dtatum7/ESP32-RC/README.md

ESP32 based remote control system with 8 PWM outputs reconfigurable as controller ADC inputs with SparkFun QWIIC / Adafruit STEMMA connections for easy customization.
