dtatum7/ESP32-RC/ESP32-RC_R1.pdf

# WaCS-1 ESP32 Remote Robotics Control System

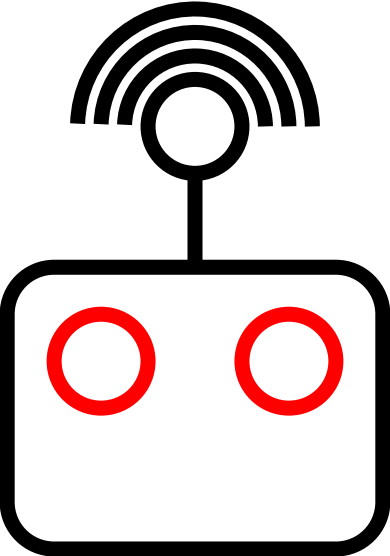
[picture p1: figure]

Dan Tatum
27 February 2025

## WaCS-1 ESP32 Remote Robotics Control System Overview

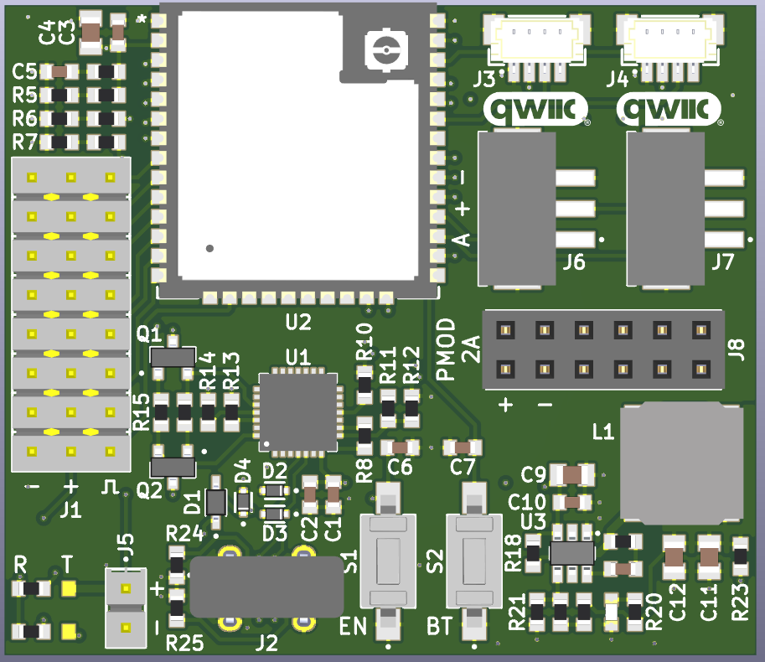
[picture p2: figure]

- Up to 8 PWM servos
- Dual SparkFun QWIIC / Adafruit STEMMA I²C connections
- Dual Adafruit STEMMA analog connections
- Digilent PMOD 2A SPI connection
- USB-C connector for firmware upload
- U.FL connector for improved antenna performance
- Voltage monitors for on board 3.3V supply, ESC, and external battery
- High efficiency switch mode power supply
- Reconfigurable to support potentiometer inputs from remote controller
- 1.92” x 1.66” PCBA area

## Up to 8 PWM Servos

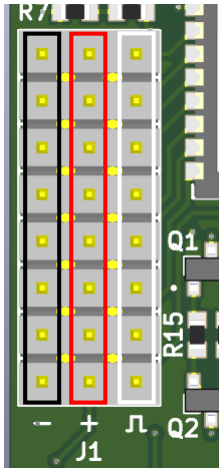
[picture p3: figure]
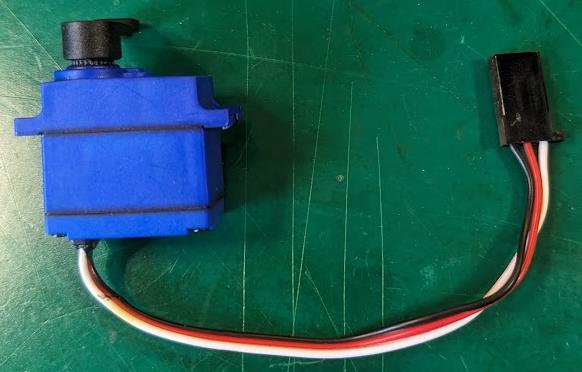
[picture p4: figure]

- Supports up to 8 PWM based servos
- 0.1” square pin headers
- ESC power pass through to servos
- Controller powered by ESC

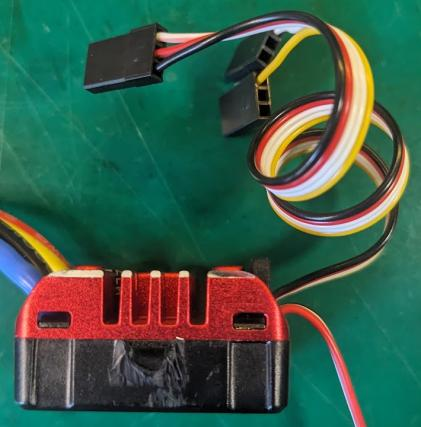
[picture p5: figure]

## Dual SparkFun QWIIC / Adafruit STEMMA QT

I

## 2C Connections

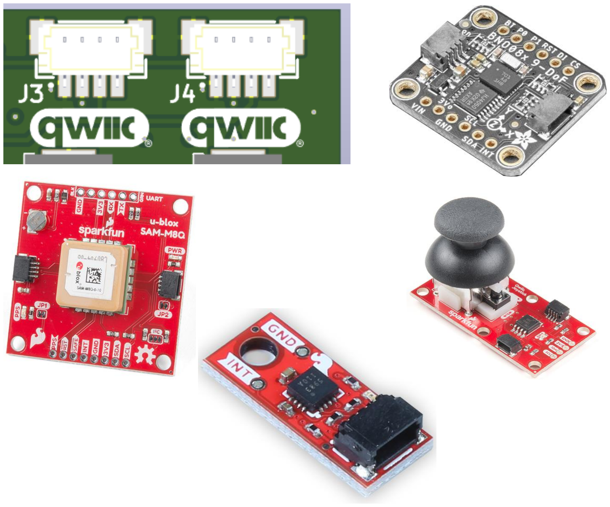
[picture p6: figure]

- A world of possibilities with readily
available off-the-shelf components
- JST type SH 4-pin 1mm connector
- GPS, IMU, screens, sensors, etc.
- Developers can focus on software and ditch the rat’s nest
- https://www.sparkfun.com/categories/399 (https://www.sparkfun.com/categories/399)
- https://www.adafruit.com/category/1018 (https://www.adafruit.com/category/1018)

## Dual Adafruit STEMMA Analog Connections

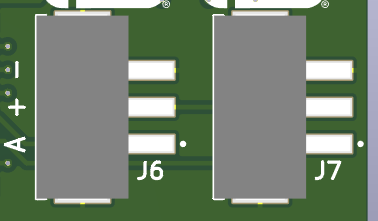
[picture p7: figure]
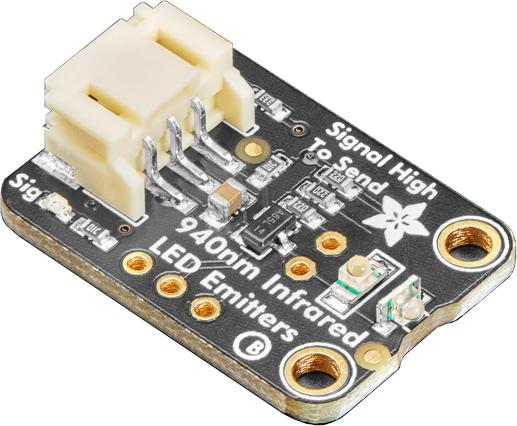
[picture p8: figure]

- Analog and GPIO
- A world of possibilities with
readily available off-the-shelf components
- JST type PH 3-pin 2mm
connector
- IR communication, buttons, amplifiers, etc.
- https://www.adafruit.com/category/1019 (https://www.adafruit.com/category/1019)

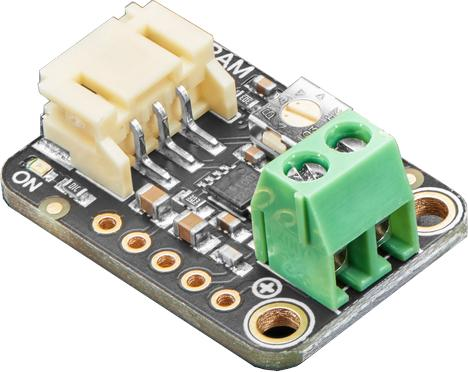
[picture p9: figure]
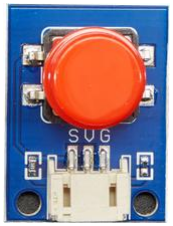
[picture p10: figure]

## Digilent PMOD 2A SPI Connection

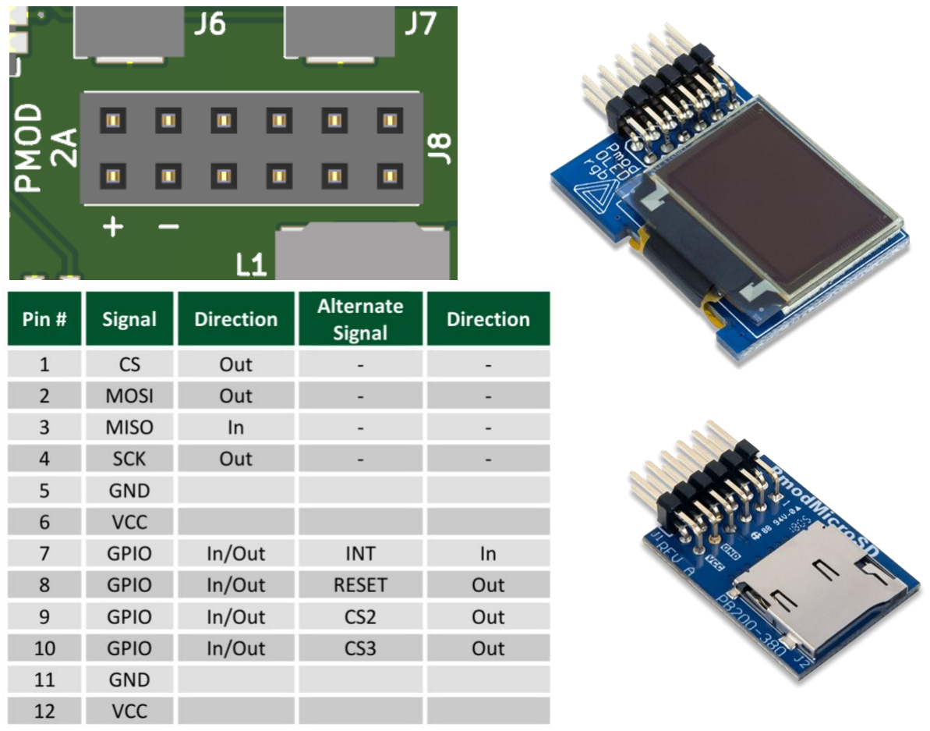
[picture p11: figure]

- Dual SPI connections
- A world of possibilities with
readily available off-the-shelf components
- 2x6 pin 0.1” square receptacle
- https://digilent.com/shop/products/fpga-boards/expansionmodules/pmods/ (https://digilent.com/shop/products/fpga-boards/expansion-modules/pmods/)

## USB-C connector for firmware upload

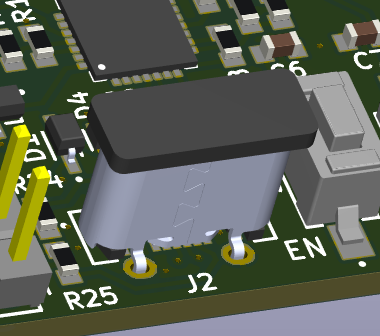
[picture p12: figure]
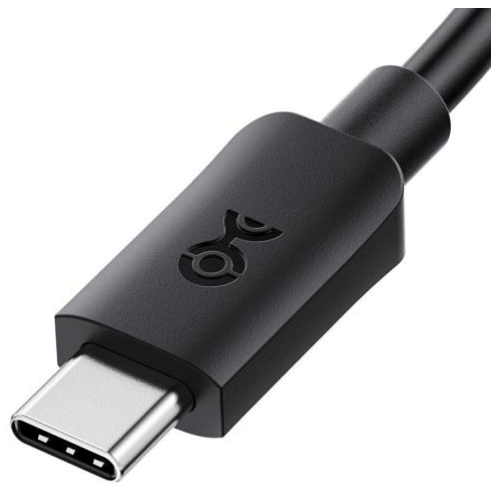
[picture p13: figure]

- Common, current, reversable
connection
- Integrated Silicon Labs CP2102 USB to serial converter
- No hunting for old, oddball cables or adapters
- Mounted perpendicular to board for easy in-unit access
- USB 2.0 for easy compatibility

## Additional Connections

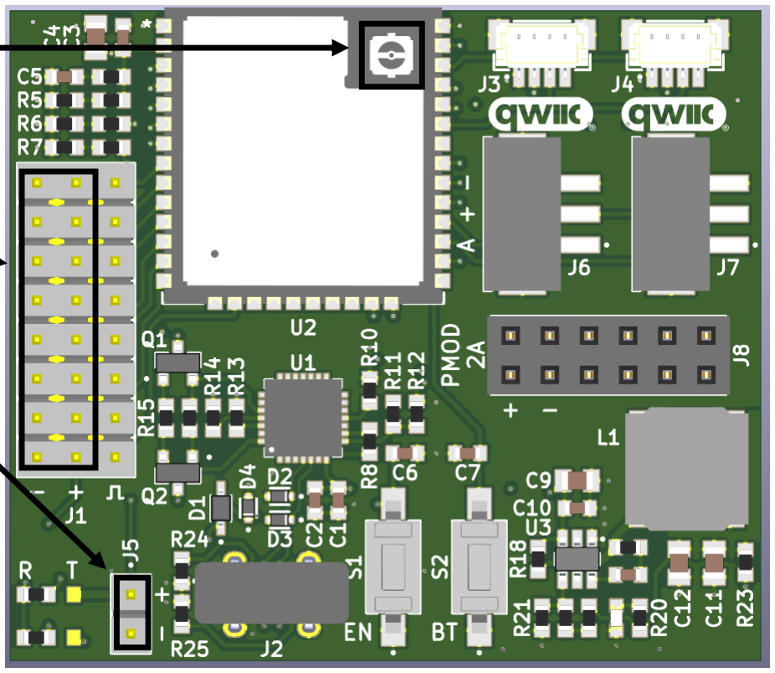
[picture p14: figure]

- U.FL connector for improved antenna performance
- Voltage monitors for on board 3.3V supply, ESC, and external battery

## High efficiency switch mode power supply

- Operational input voltage 4.2V-18V
- 3.3V, 2A output to PCBA and external accessories

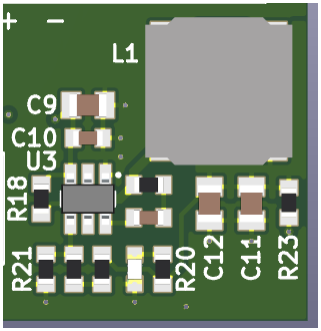
[picture p15: figure]

## Reconfigurable for Potentiometer Inputs from Remote Controller

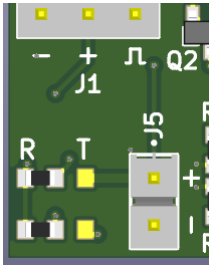
[picture p16: figure]

- Populate R1, R22 to left side
pads
- Input power sourced from J5 external power monitoring input
- J1 sources 3.3V to external potentiometers and connects wiper to ADC input
- Inputs reconfigured in software

# PCBA 3D View

## PCBA Front

## PCBA Back

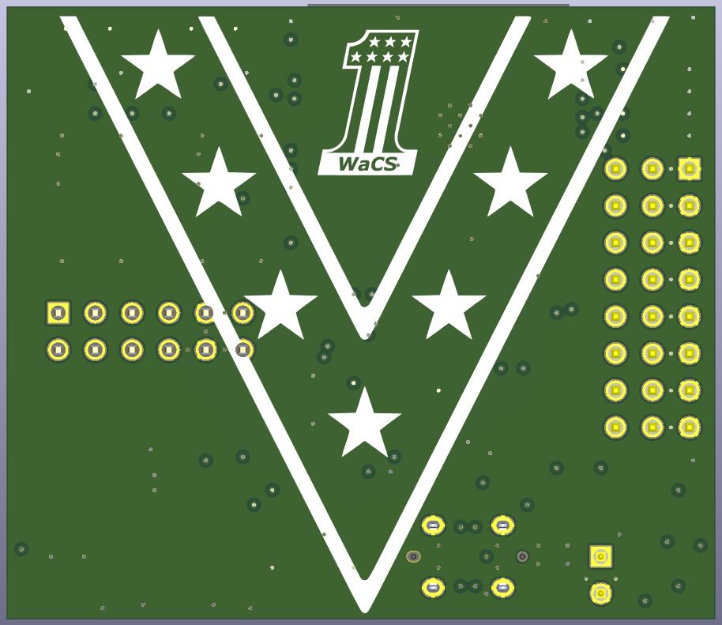
[picture p17: figure]

## PCBA Front Isometric

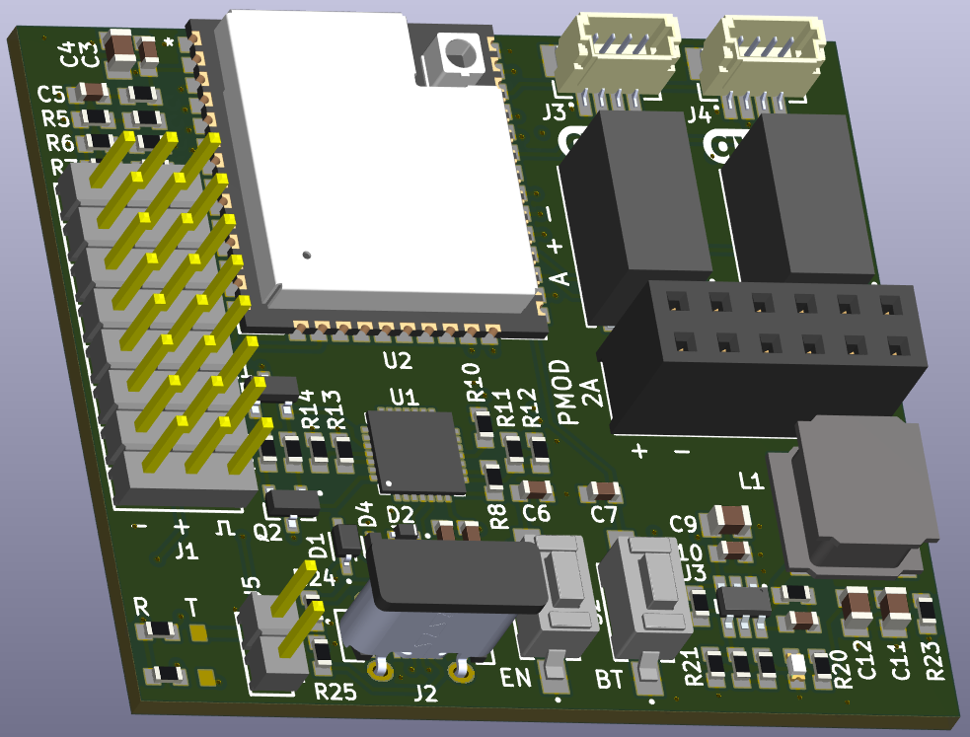
[picture p18: figure]

# PCBA Schematic

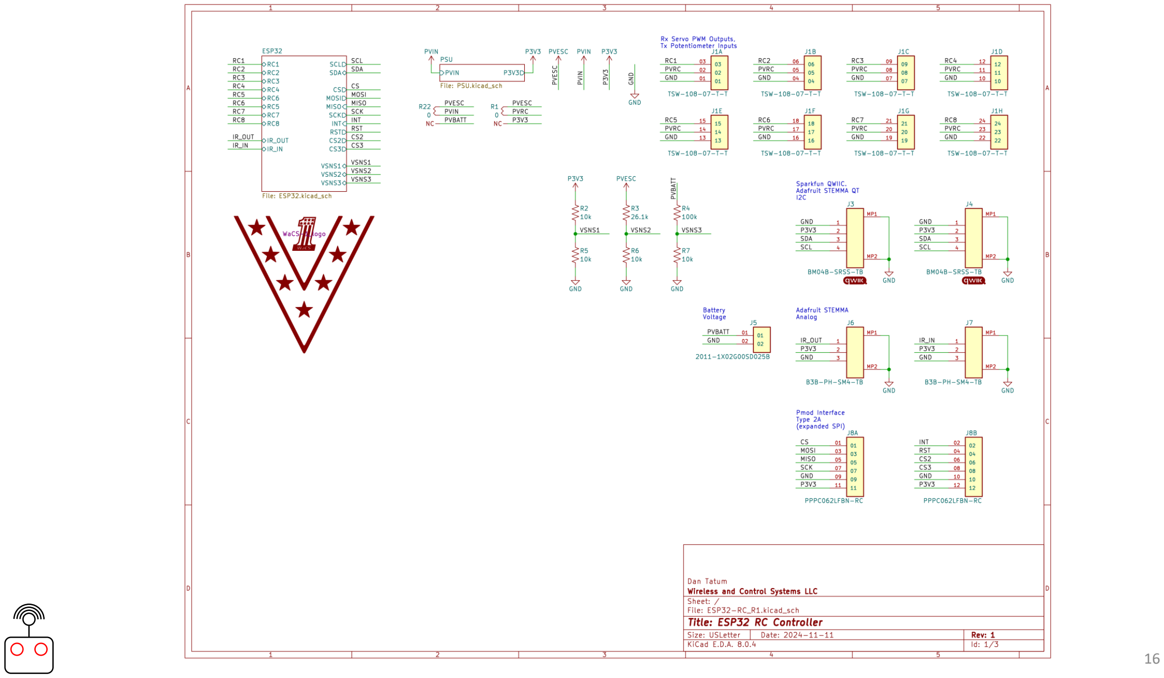
[picture p19: page 16]
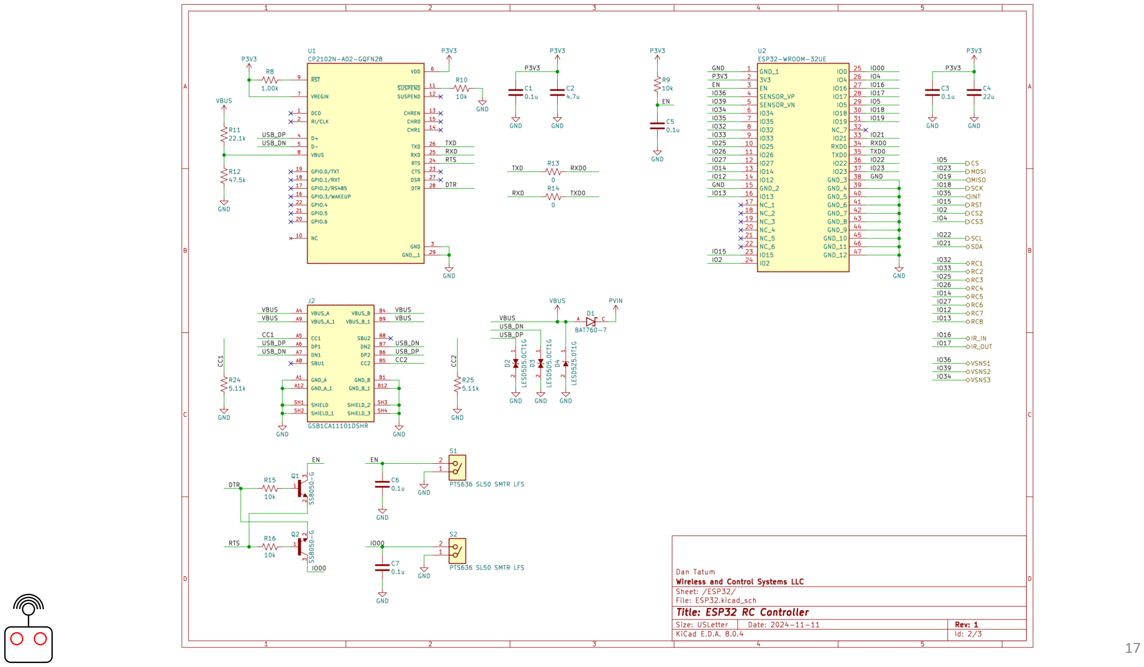
[picture p20: page 17]
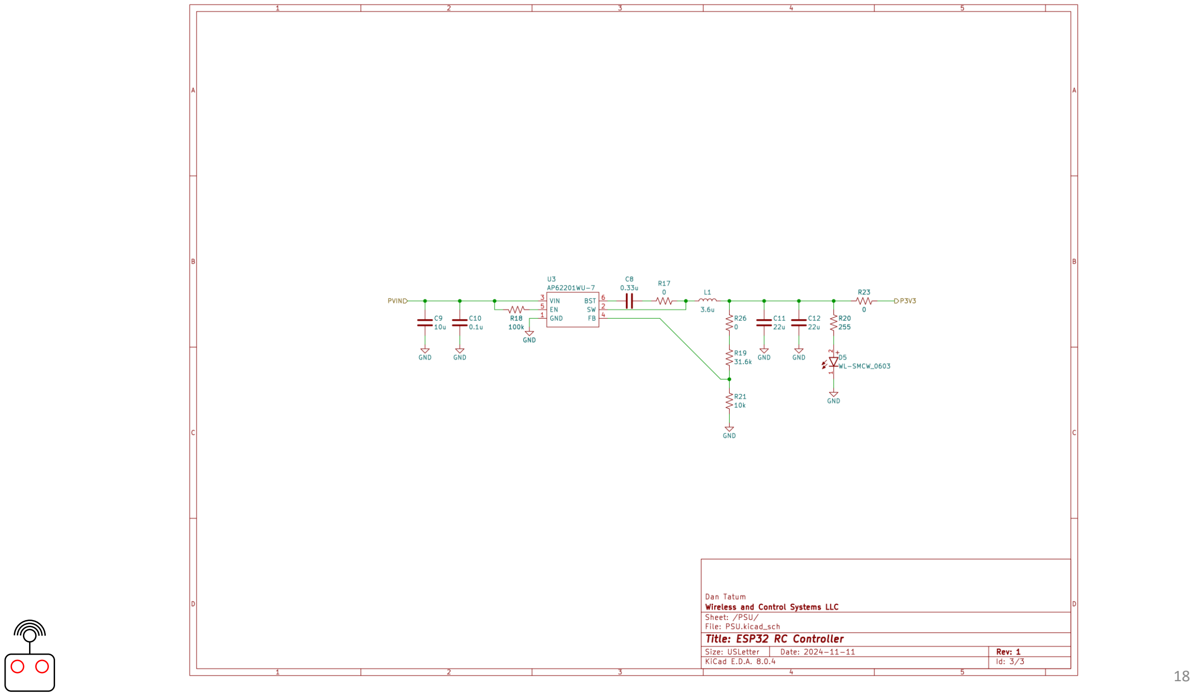
[picture p21: page 18]

# PCBA Gerbers

## PCBA Extents

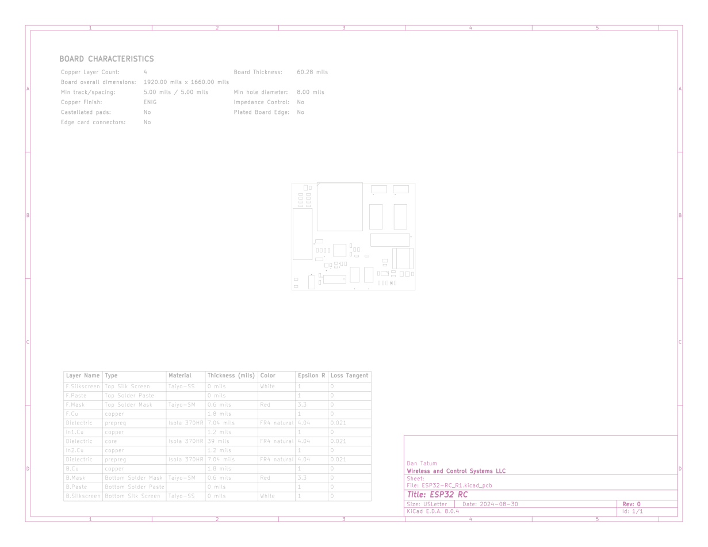
[picture p22: figure]

## PCBA Top Layer

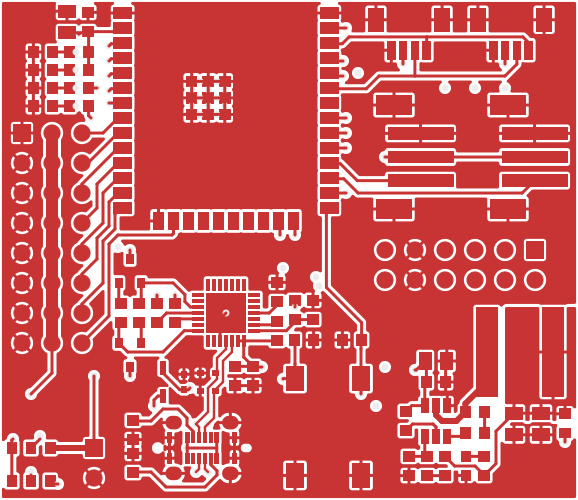
[picture p23: figure]

## PCBA Layer 1

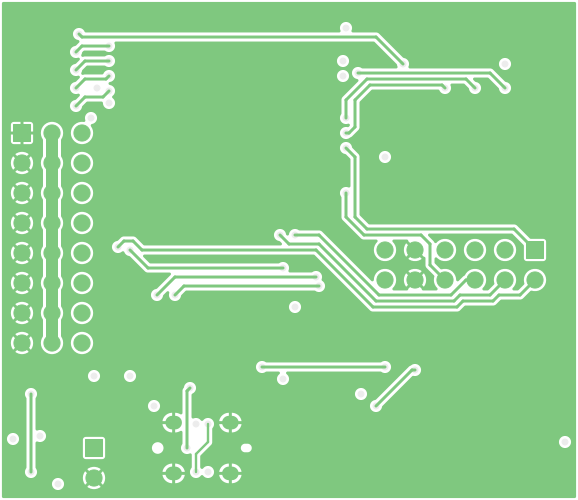
[picture p24: figure]

## PCBA Layer 2

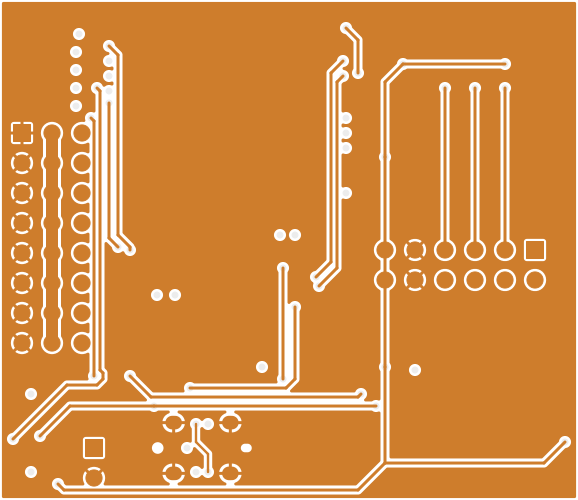
[picture p25: figure]

## PCBA Bottom Layer

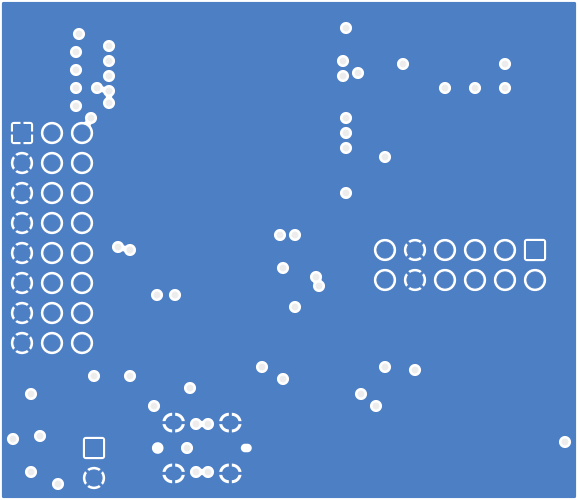
[picture p26: figure]

## WaCS-1 Availability

Developmental units will be made available by contacting the developer Dan Tatum via email dan@wcsrf.com
