dtatum7/ESP32-RC/Images/Champion.png

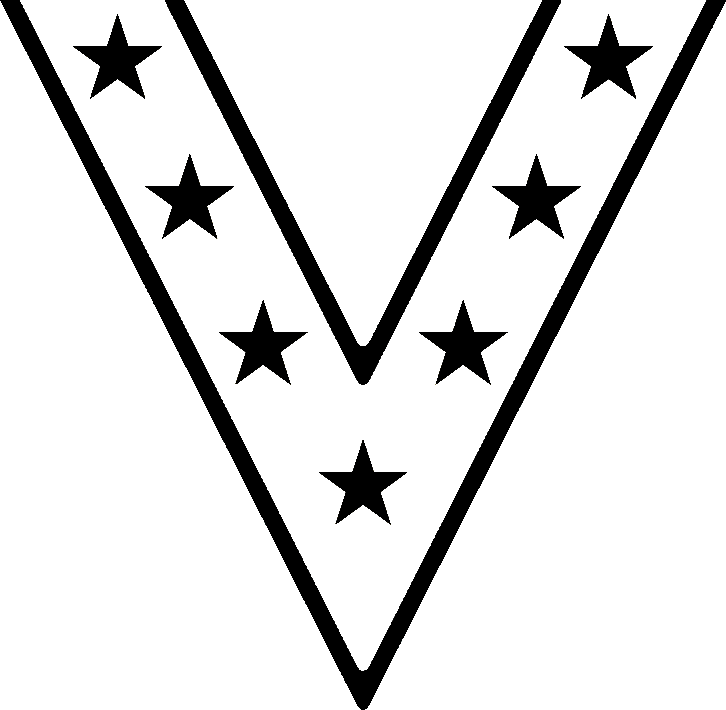
Images/Champion.png
