dtatum7/ESP32-RC/Schematic/ESP32-RC_R1.pdf

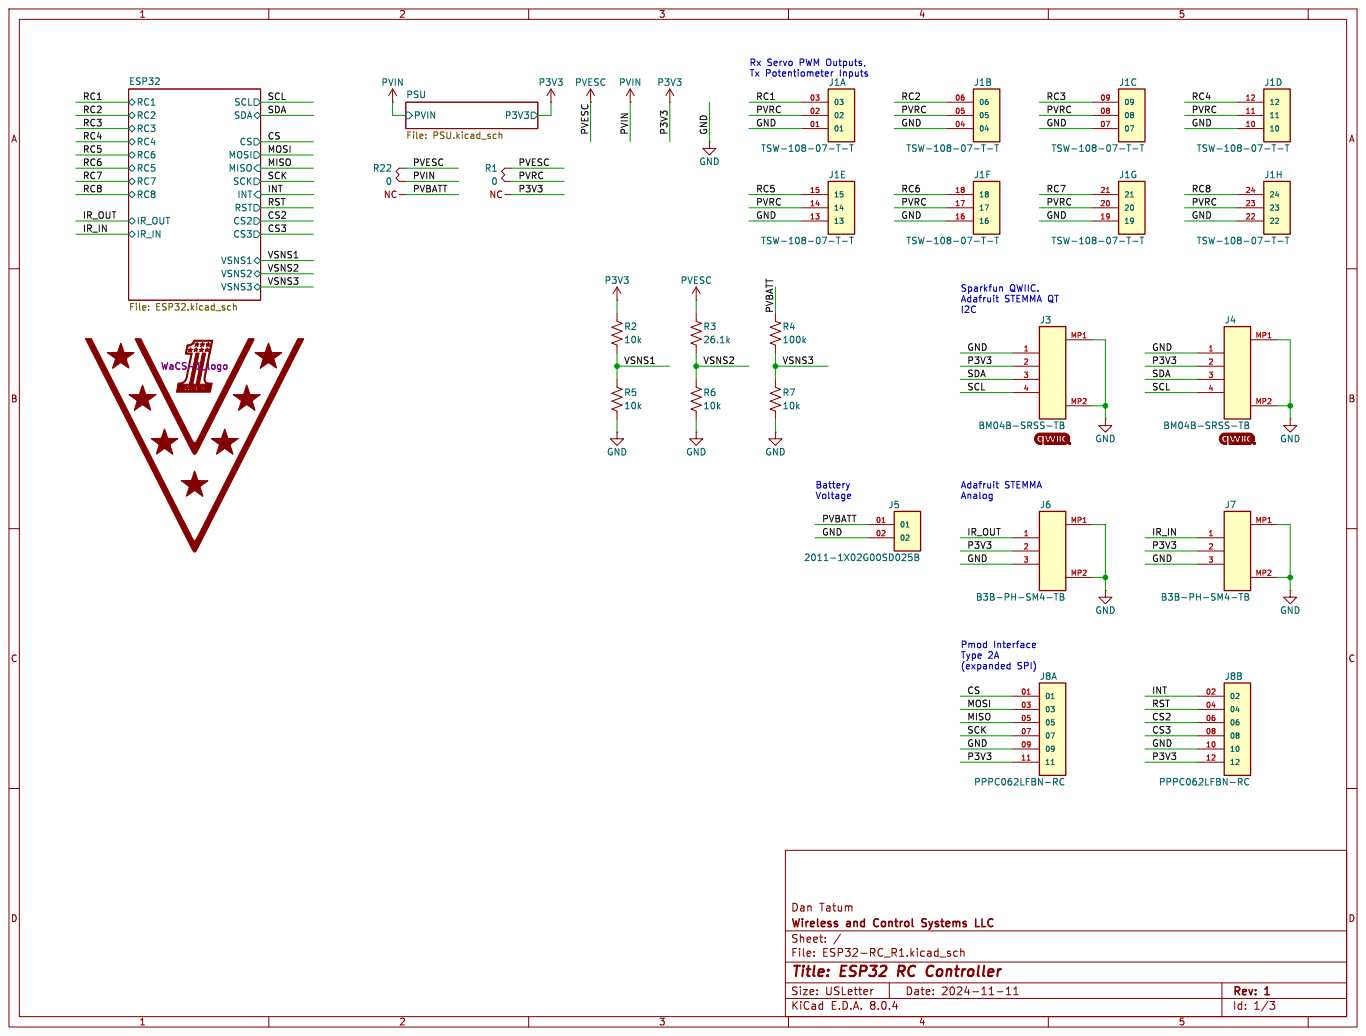
[picture p28: page 1]

TSW-108-07-T-TPVBATT RST CS

Sparkfun QWIIC. Adafruit STEMMA QT

INT RST SCL GND

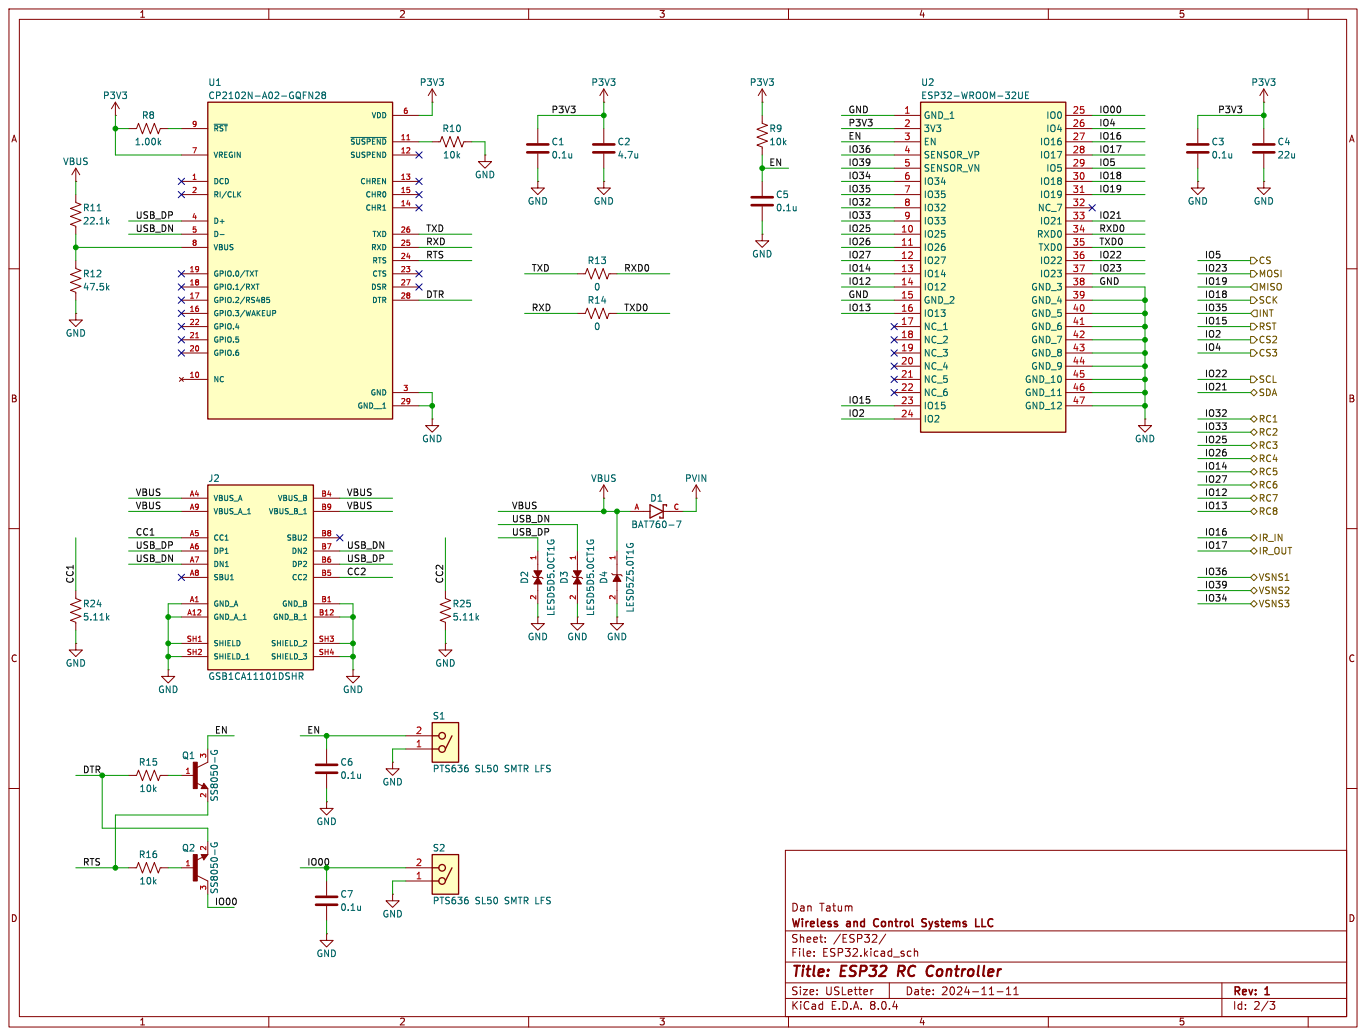
[picture p29: page 2]

RC2 CSMOSI MISO
INT SCL VSNS1 RC5 RC7 RST RC6 RC8 SDA RC3 RC1 VSNS3 VSNS2

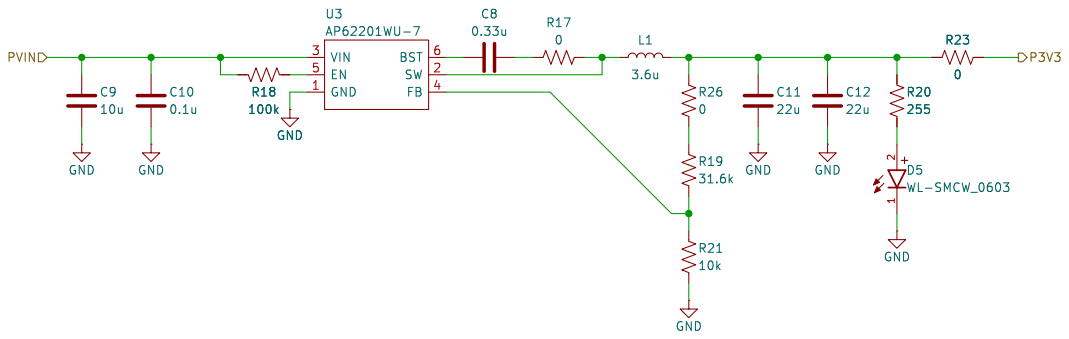
[picture p30: page 3]
