dtatum7/ESP32-RC/Gerbers/ESP32-RC_R1-B_Cu.pdf

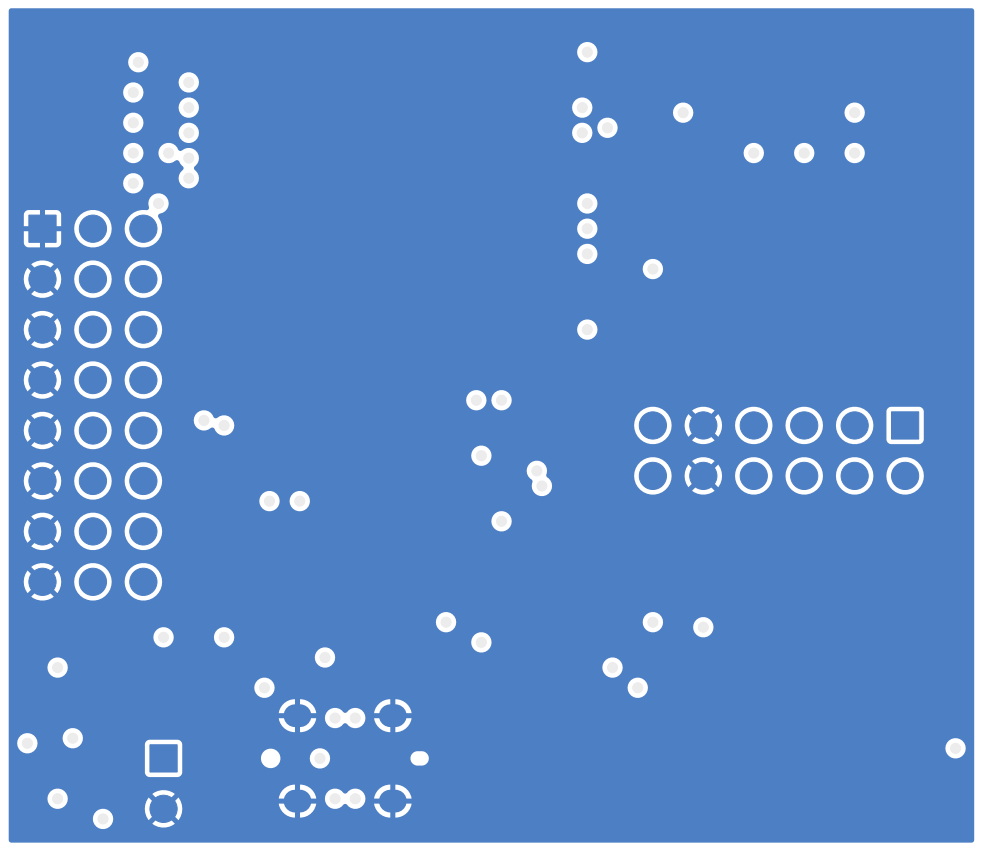
[picture p31: page 1]
