dtatum7/ESP32-RC/Gerbers/ESP32-RC_R1-F_Cu.pdf

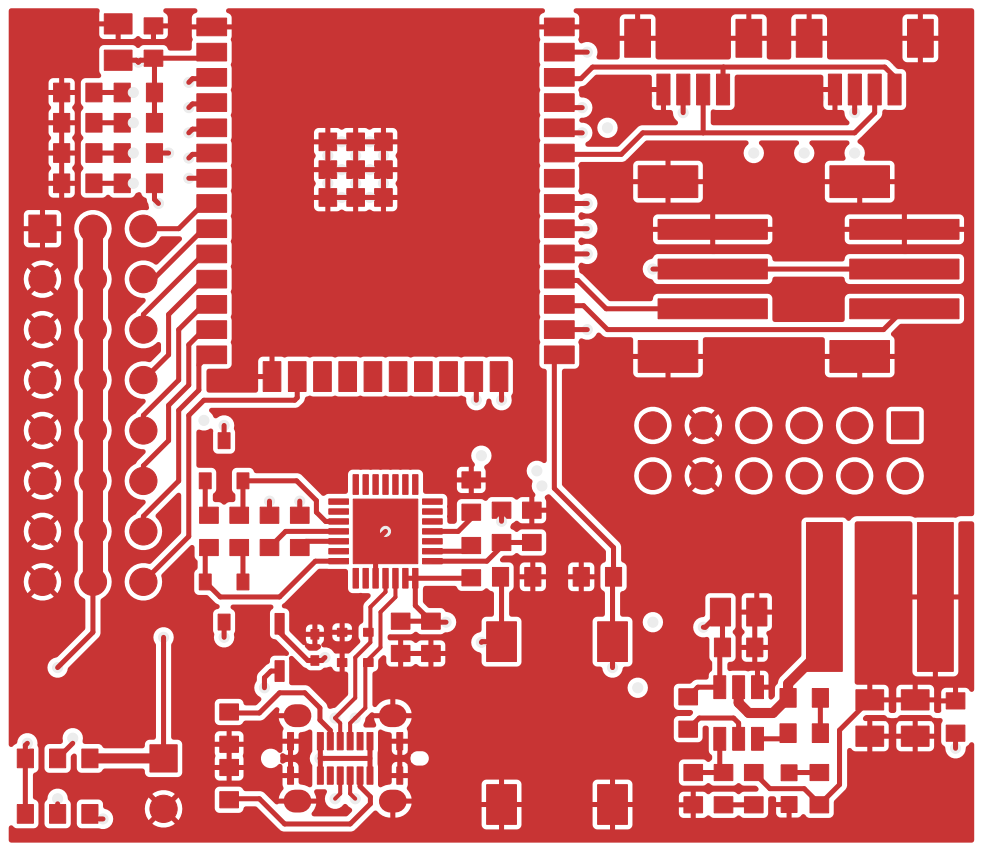
[picture p32: page 1]
