dtatum7/ESP32-RC/Gerbers/ESP32-RC_R1-In1_Cu.pdf

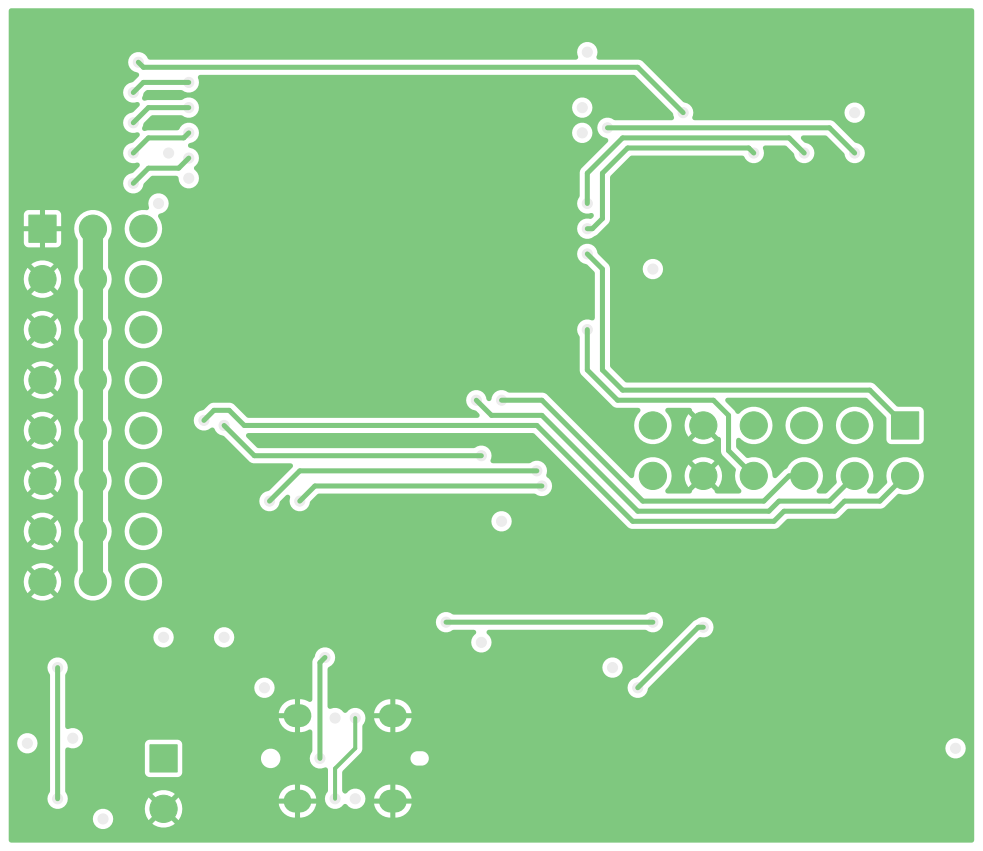
[picture p33: page 1]
