dtatum7/ESP32-RC/Gerbers/ESP32-RC_R1-In2_Cu.pdf

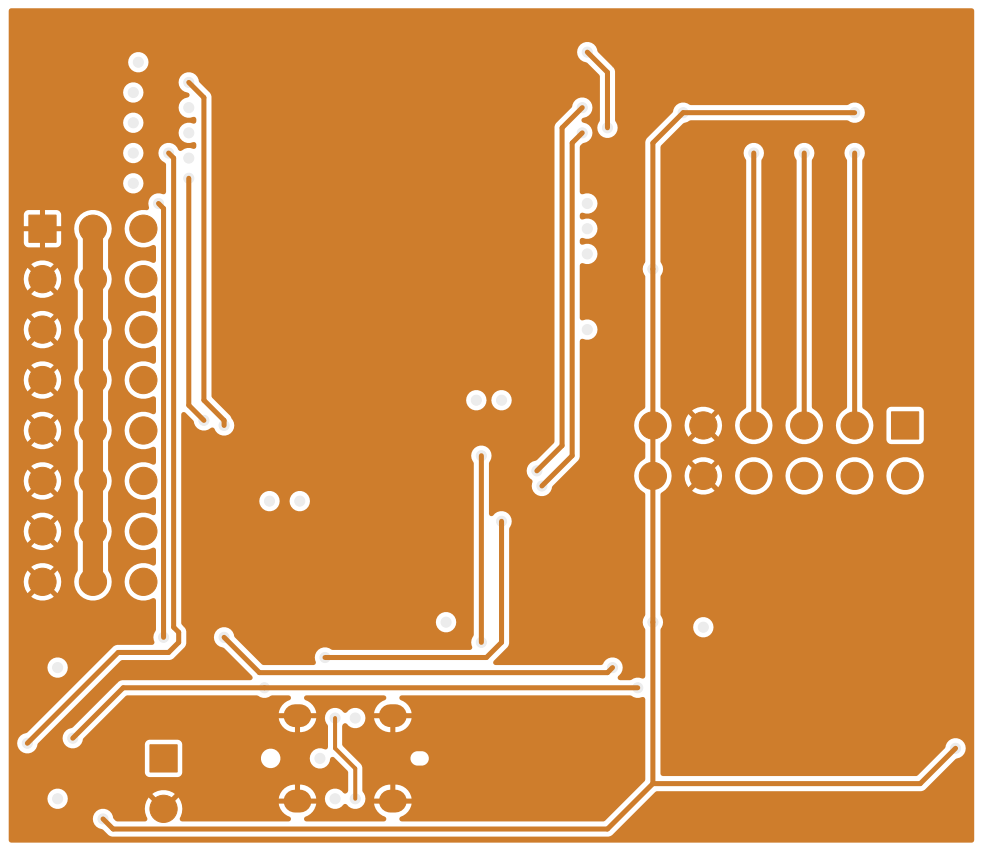
[picture p34: page 1]
