dtatum7/ESP32-RC/ESP32-RC_R1.kicad_pcb

## KiCad design ESP32-RC_R1.kicad_pcb (2025-03-25)

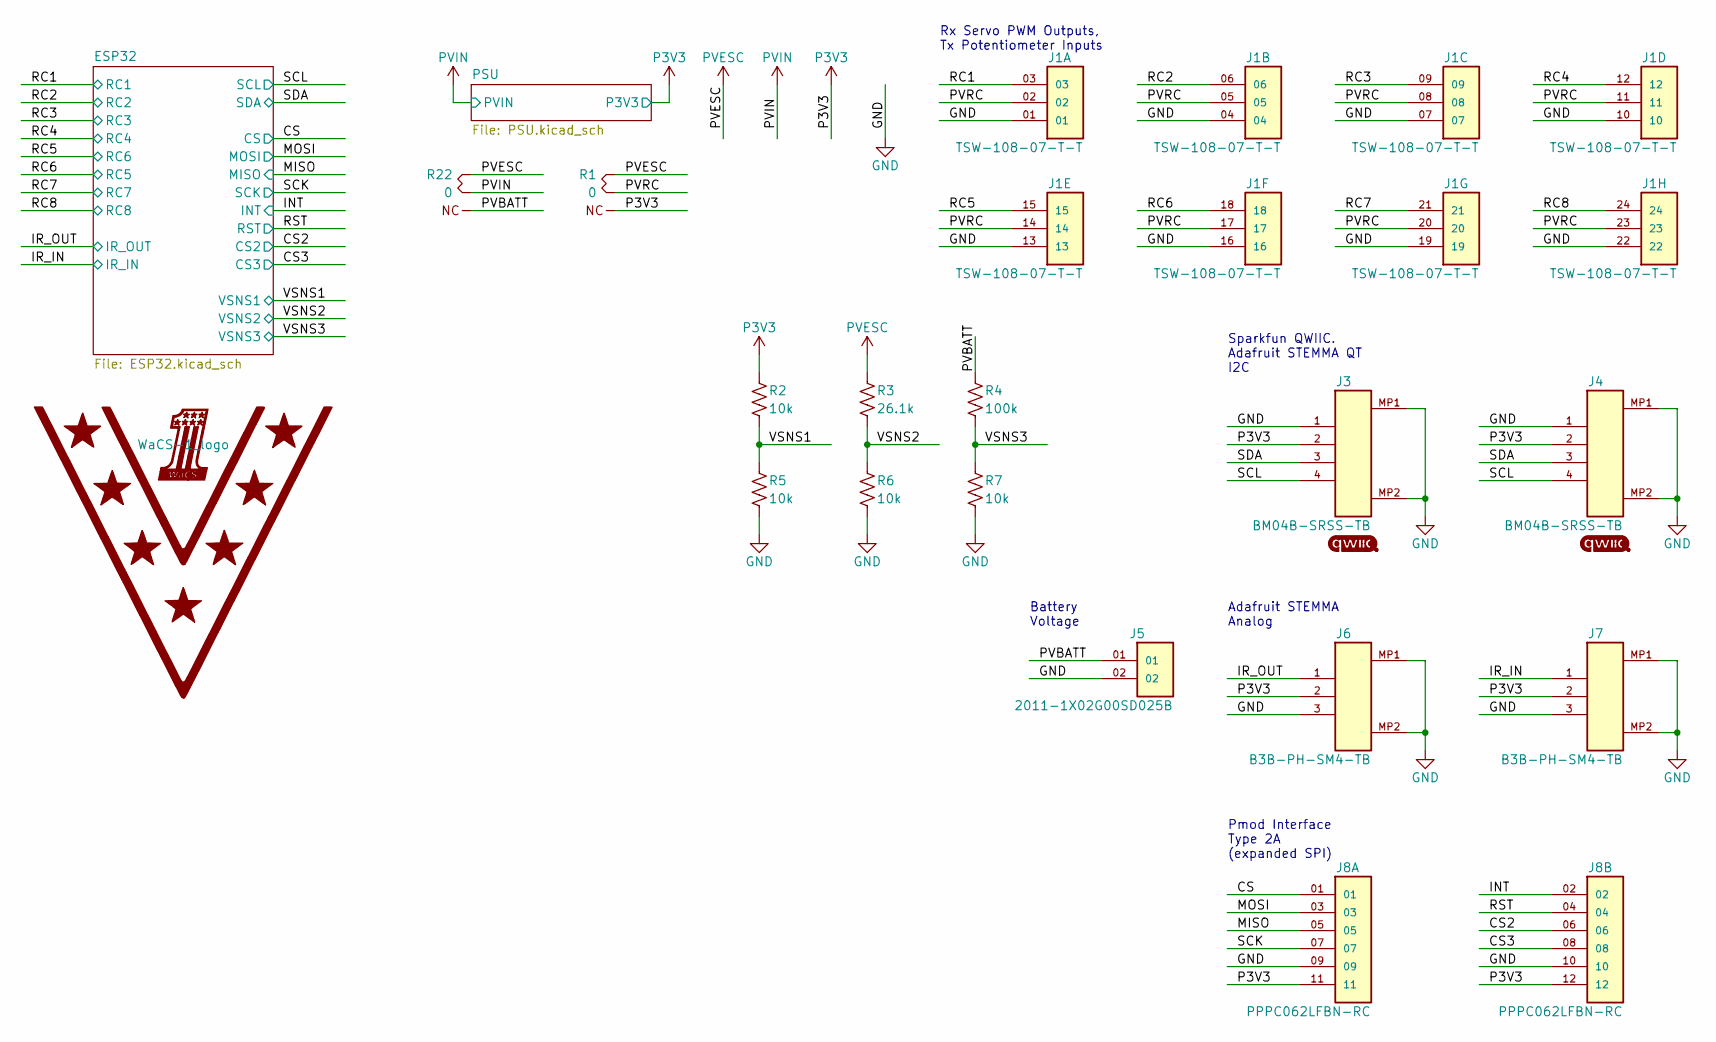
[picture p35: schematic ESP32-RC_R1.kicad_sch, ESP32 RC Controller]

Parts:
G1, G2: QWIIC_logo; MPN QWIIC_logo
G5: WaCS-1_logo; MPN WaCS-1_logo
G6: Champion logo; MPN Champion_Logo
J1: TSW-108-07-T-T; SAMTEC_TSW-108-07-T-T; MPN TSW-108-07-T-T
J3, J4: BM04B-SRSS-TB; BM04B-SRSS_JST; MPN BM04B-SRSS-TB
J5: 2011-1X02G00SD025B; MPN 2011-1X02G00SD025B
J6, J7: B3B-PH-SM4-TB; MPN B3B-PH-SM4-TB
J8: PPPC062LFBN-RC; MPN TSW-108-07-T-T
R1, R22: 0; R0603_3; MPN CRCW06030000Z0EAC
R2, R5, R6, R7: 10k; R0603; MPN CRCW060310K0FKEAC
R3: 26.1k; R0603; MPN CRCW060326K1FKEAC
R4: 100k; R0603; MPN CRCW0603100KFKEAC

Connections:
/CS: J8.01; also elsewhere on the board
/CS2: J8.06; also elsewhere on the board
/CS3: J8.08; also elsewhere on the board
/INT: J8.02; also elsewhere on the board
/IR_IN: J7.1; also elsewhere on the board
/IR_OUT: J6.1; also elsewhere on the board
/MISO: J8.05; also elsewhere on the board
/MOSI: J8.03; also elsewhere on the board
/PVBATT: J5.01, R4.1, R22.3
/PVRC: J1.02, J1.05, J1.08, J1.11, J1.14, J1.17, J1.20, J1.23, R1.2
/RC1: J1.03; also elsewhere on the board
/RC2: J1.06; also elsewhere on the board
/RC3: J1.09; also elsewhere on the board
/RC4: J1.12; also elsewhere on the board
/RC5: J1.15; also elsewhere on the board
/RC6: J1.18; also elsewhere on the board
/RC7: J1.21; also elsewhere on the board
/RC8: J1.24; also elsewhere on the board
/RST: J8.04; also elsewhere on the board
/SCK: J8.07; also elsewhere on the board
/SCL: J3.4, J4.4; also elsewhere on the board
/SDA: J3.3, J4.3; also elsewhere on the board
/VSNS1: R2.2, R5.1; also elsewhere on the board
/VSNS2: R3.2, R6.1; also elsewhere on the board
/VSNS3: R4.2, R7.1; also elsewhere on the board
GND: J1.01, J1.04, J1.07, J1.10, J1.13, J1.16, J1.19, J1.22, J3.1, J3.MP1, J3.MP2, J4.1, J4.MP1, J4.MP2, J5.02, J6.3, J6.MP1, J6.MP2, J7.3, J7.MP1, J7.MP2, J8.09, J8.10, R5.2, R6.2, R7.2; also elsewhere on the board
P3V3: J3.2, J4.2, J6.2, J7.2, J8.11, J8.12, R1.3, R2.1; also elsewhere on the board
PVESC: R1.1, R3.1, R22.1
PVIN: R22.2; also elsewhere on the board

Notes on the sheet:
Adafruit STEMMA Analog
Sparkfun QWIIC. Adafruit STEMMA QT I2C
Battery Voltage
Rx Servo PWM Outputs, Tx Potentiometer Inputs
Pmod Interface Type 2A (expanded SPI)

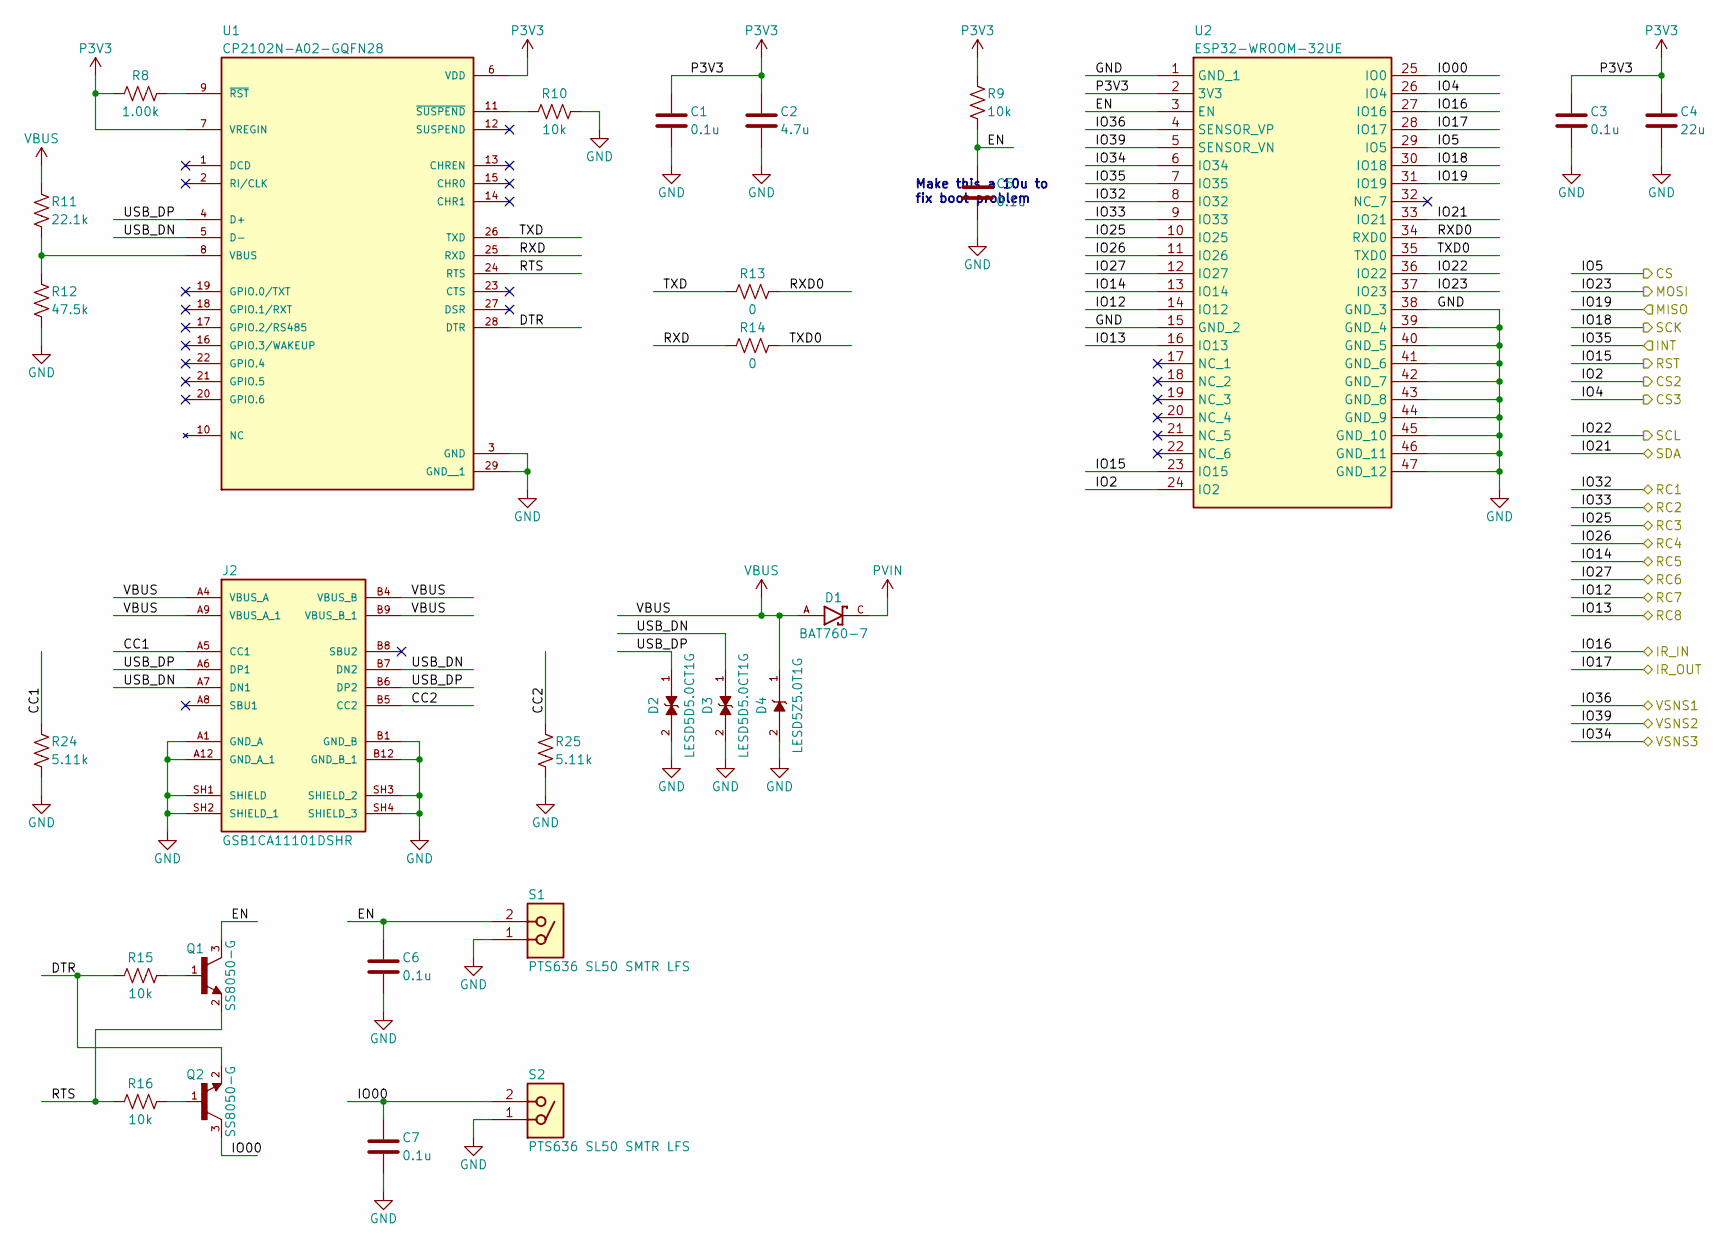
[picture p36: schematic ESP32.kicad_sch, ESP32 RC Controller]

Parts:
C1, C3, C5, C6, C7: 0.1u; C0603; MPN CC0603KRX7R7BB104
C2: 4.7u; C0603; MPN CL10A475KP8NNNC
C4: 22u; C0805; MPN CL21A226MOCLRNC
D1: BAT760-7; SOD-323; MPN BAT760-7
D2, D3: LESD5D5.0CT1G; SOD-523; MPN LESD5D5.0CT1G
D4: LESD5Z5.0T1G; SOD-523; MPN LESD5Z5.0T1G
J2: GSB1CA11101DSHR; AMPHENOL_GSB1CA11101DSHR; MPN GSB1CA11101DSHR
Q1, Q2: SS8050-G; SOT-23-3; MPN SS8050-G
R8: 1.00k; R0603; MPN CRCW06031K00FKEAC
R9, R10, R15, R16: 10k; R0603; MPN CRCW060310K0FKEAC
R11: 22.1k; R0603; MPN CRCW060322K1FKEAC
R12: 47.5k; R0603; MPN CRCW060347K5FKEAC
R13, R14: 0; R0603; MPN CRCW06030000Z0EAC
R24, R25: 5.11k; R0603; MPN CRCW06035K11FKEAC
S1, S2: PTS636 SL50 SMTR LFS; PTS636SL50SMTRLFS; MPN PTS636 SL50 SMTR LFS
U1: CP2102N-A02-GQFN28; 28-WFQFN; MPN CP2102N-A02-GQFN28
U2: ESP32-WROOM-32UE; ESP32-32UE_EXP; MPN ESP32-WROOM-32UE

Connections:
/CS: U2.29 (IO5); also elsewhere on the board
/CS2: U2.24 (IO2); also elsewhere on the board
/CS3: U2.26 (IO4); also elsewhere on the board
/ESP32/CC1: J2.A5 (CC1), R24.1
/ESP32/CC2: J2.B5 (CC2), R25.1
/ESP32/DTR: Q2.2, R15.1, U1.28 (DTR)
/ESP32/EN: C5.1, C6.1, Q1.3, R9.2, S1.2, U2.3 (EN)
/ESP32/IO00: C7.1, Q2.3, S2.2, U2.25 (IO0)
/ESP32/RTS: Q1.2, R16.1, U1.24 (RTS)
/ESP32/RXD: R14.1, U1.25 (RXD)
/ESP32/RXD0: R13.2, U2.34 (RXD0)
/ESP32/TXD: R13.1, U1.26 (TXD)
/ESP32/TXD0: R14.2, U2.35 (TXD0)
/ESP32/USB_DN: D3.1, J2.A7 (DN1), J2.B7 (DN2), U1.5 (D-)
/ESP32/USB_DP: D2.1, J2.A6 (DP1), J2.B6 (DP2), U1.4 (D+)
/INT: U2.7 (IO35); also elsewhere on the board
/IR_IN: U2.27 (IO16); also elsewhere on the board
/IR_OUT: U2.28 (IO17); also elsewhere on the board
/MISO: U2.31 (IO19); also elsewhere on the board
/MOSI: U2.37 (IO23); also elsewhere on the board
/RC1: U2.8 (IO32); also elsewhere on the board
/RC2: U2.9 (IO33); also elsewhere on the board
/RC3: U2.10 (IO25); also elsewhere on the board
/RC4: U2.11 (IO26); also elsewhere on the board
/RC5: U2.12 (IO27); also elsewhere on the board
/RC6: U2.13 (IO14); also elsewhere on the board
/RC7: U2.14 (IO12); also elsewhere on the board
/RC8: U2.16 (IO13); also elsewhere on the board
/RST: U2.23 (IO15); also elsewhere on the board
/SCK: U2.30 (IO18); also elsewhere on the board
/SCL: U2.36 (IO22); also elsewhere on the board
/SDA: U2.33 (IO21); also elsewhere on the board
/VSNS1: U2.4 (SENSOR_VP); also elsewhere on the board
/VSNS2: U2.5 (SENSOR_VN); also elsewhere on the board
/VSNS3: U2.6 (IO34); also elsewhere on the board
GND: C1.2, C2.2, C3.2, C4.2, C5.2, C6.2, C7.2, D2.2, D3.2, D4.2, J2.A1 (GND_A), J2.A12 (GND_A_1), J2.B1 (GND_B), J2.B12 (GND_B_1), J2.SH1 (SHIELD), J2.SH2 (SHIELD_1), J2.SH3 (SHIELD_2), J2.SH4 (SHIELD_3), R10.2, R12.2, R24.2, R25.2, S1.1, S2.1, U1.3 (GND), U1.29 (GND__1), U2.1 (GND_1), U2.15 (GND_2), U2.38 (GND_3), U2.39 (GND_4), U2.40 (GND_5), U2.41 (GND_6), U2.42 (GND_7), U2.43 (GND_8), U2.44 (GND_9), U2.45 (GND_10), U2.46 (GND_11), U2.47 (GND_12); also elsewhere on the board
unnamed: Q1.1, R15.2
unnamed: Q2.1, R16.2
unnamed: R11.2, R12.1, U1.8 (VBUS)
unnamed: R8.2, U1.9 (~RST)
unnamed: R10.1, U1.11 (~SUSPEND)
P3V3: C1.1, C2.1, C3.1, C4.1, R8.1, R9.1, U1.6 (VDD), U1.7 (VREGIN), U2.2 (3V3); also elsewhere on the board
PVIN: D1.C; also elsewhere on the board
VBUS: D1.A, D4.1, J2.A4 (VBUS_A), J2.A9 (VBUS_A_1), J2.B4 (VBUS_B), J2.B9 (VBUS_B_1), R11.1

Notes on the sheet:
Make this a 10u to fix boot problem

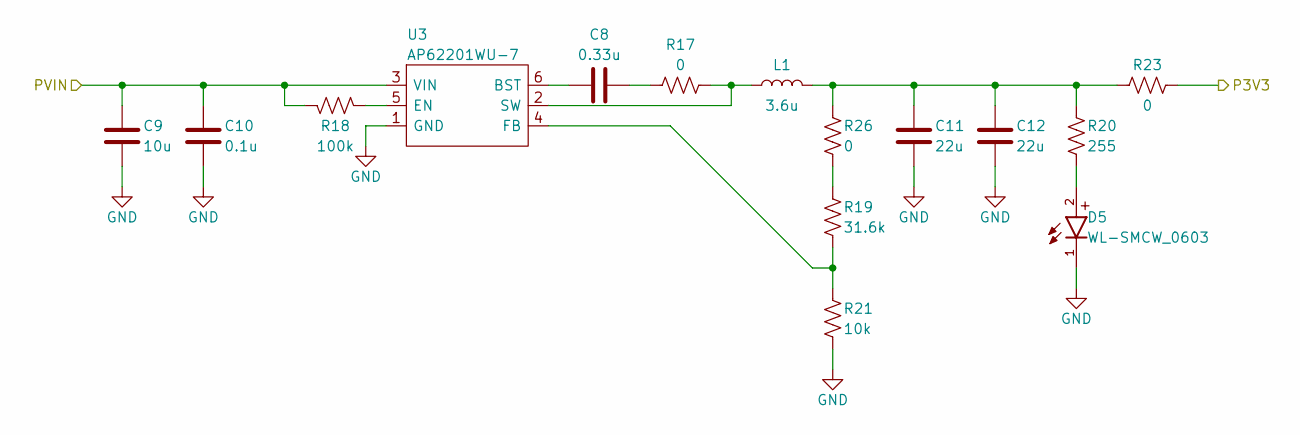
[picture p37: schematic PSU.kicad_sch, ESP32 RC Controller]

Parts:
C8: 0.33u; C0603; MPN CL10B334KO8NNNC
C9: 10u; C0805; MPN CL21A106KOQNNNE
C10: 0.1u; C0603; MPN CC0603KRX7R7BB104
C11, C12: 22u; C0805; MPN CL21A226MOCLRNC
D5: WL-SMCW_0603; MPN 150060VS75000
L1: 3.6u; L3131; MPN LSXNH8080YBL3R3NJG
R17, R23, R26: 0; R0603; MPN CRCW06030000Z0EAC
R18: 100k; R0603; MPN CRCW0603100KFKEAC
R19: 31.6k; R0603; MPN CRCW060331K6FKEAC
R20: 255; R0603; MPN CRCW0603255RFKEAC
R21: 10k; R0603; MPN CRCW060310K0FKEAC
U3: AP62201WU-7; TSOT26; MPN AP62201WU-7

Connections:
GND: C9.2, C10.2, C11.2, C12.2, D5.1, R21.2, U3.1 (GND); also elsewhere on the board
unnamed: C8.2, R17.1
unnamed: C11.1, C12.1, L1.2, R20.1, R23.1, R26.1
unnamed: D5.2, R20.2
unnamed: R19.1, R26.2
unnamed: C8.1, U3.6 (BST)
unnamed: R18.2, U3.5 (EN)
unnamed: R19.2, R21.1, U3.4 (FB)
unnamed: L1.1, R17.2, U3.2 (SW)
P3V3: R23.2; also elsewhere on the board
PVIN: C9.1, C10.1, R18.1, U3.3 (VIN); also elsewhere on the board

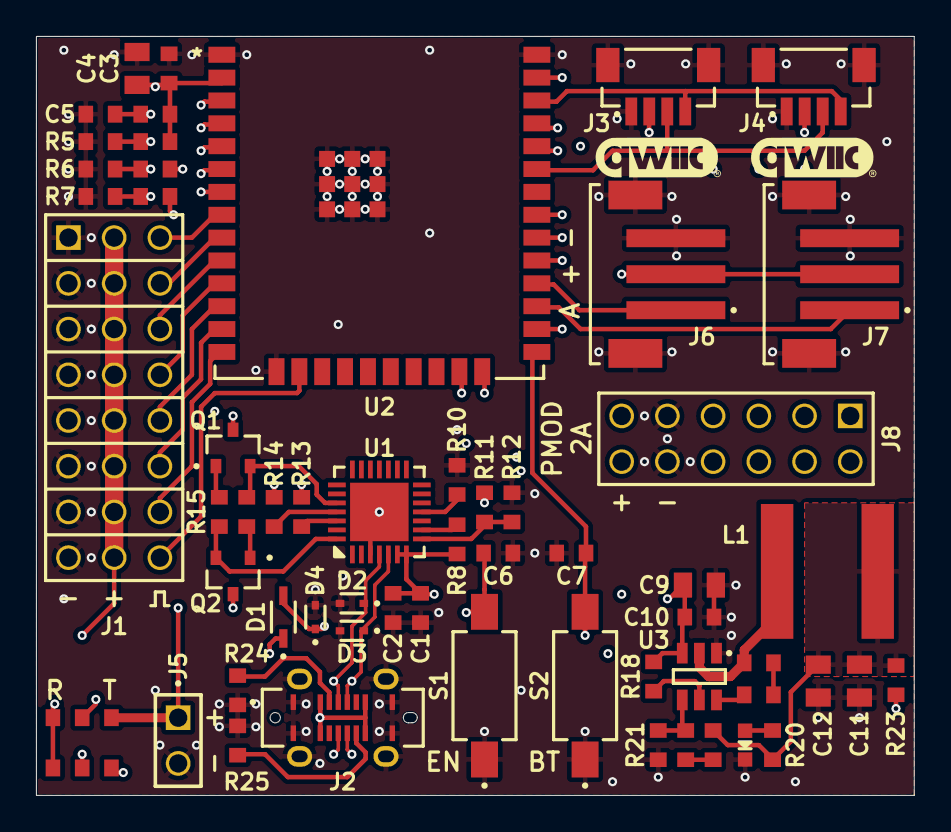
[picture p38: board ESP32-RC_R1.kicad_pcb from above]

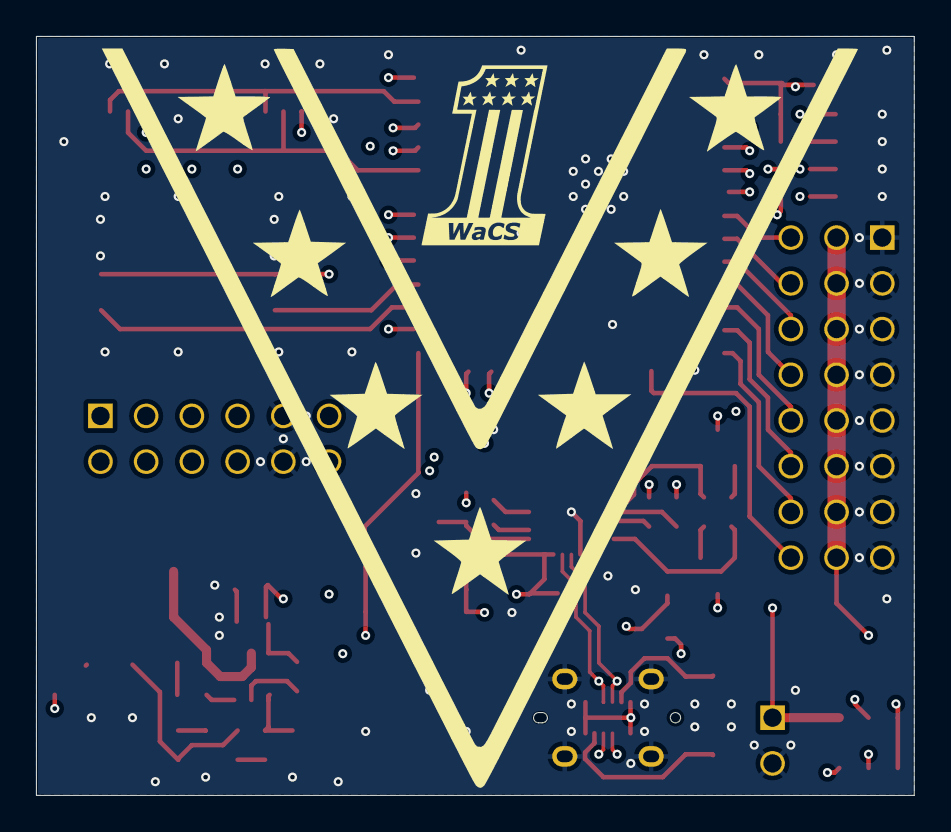
[picture p39: board ESP32-RC_R1.kicad_pcb from below]

Board: 4 copper layers, 48.8 x 42.2 mm, 63 parts (2 on the bottom side), 55 nets.
