dtatum7/ESP32-RC/(commit log)

2024-09-05 Add files via upload
    Initial commit of ESP32 RC project. Library needs a good bit of cleanup.
    [CONNECTORS.kicad_sch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]
2025-03-25 R1
    ESP32-R1
    [ESP32-RC_R0-B_Cu.gbl, ESP32-RC_R0-B_Mask.gbs, ESP32-RC_R0-B_Paste.gbp, ESP32-RC_R0-B_Silkscreen.gbo, ESP32-RC_R0-Edge_Cuts.gm1, ESP32-RC_R0-F_Cu.gtl, ESP32-RC_R0-F_Mask.gts, ESP32-RC_R0-F_Paste.gtp]
